shBLOCK/WorldCube/software/GlassLess3DGodot/assets/perspective_splicing/apple7262_0.png

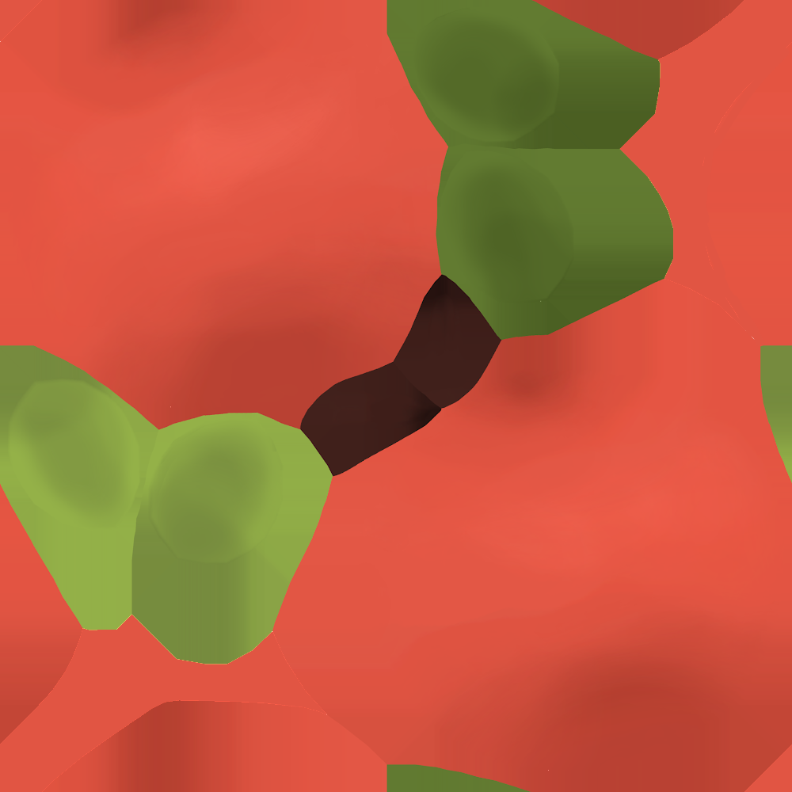
software/GlassLess3DGodot/assets/perspective_splicing/apple7262_0.png
