shBLOCK/WorldCube/software/GlassLess3DGodot/assets/demo/interactive/road2_0.png

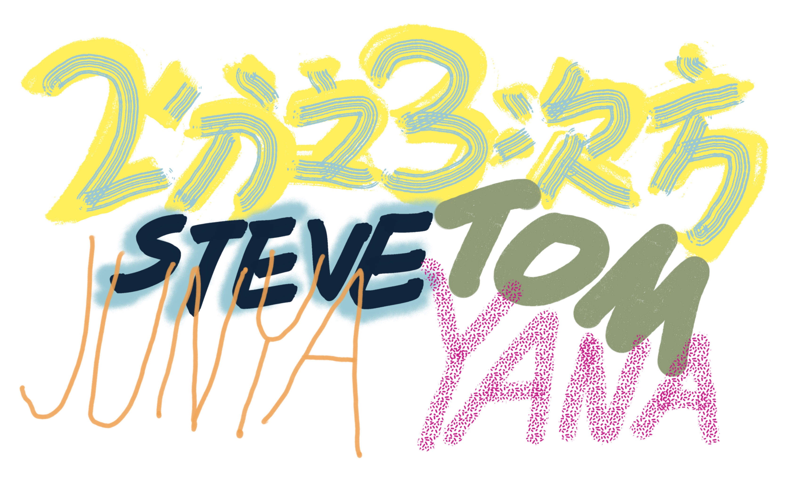
software/GlassLess3DGodot/assets/demo/interactive/road2_0.png
