shBLOCK/WorldCube/software/GlassLess3DGodot/assets/demo/misc/apple726 leaf_1.png

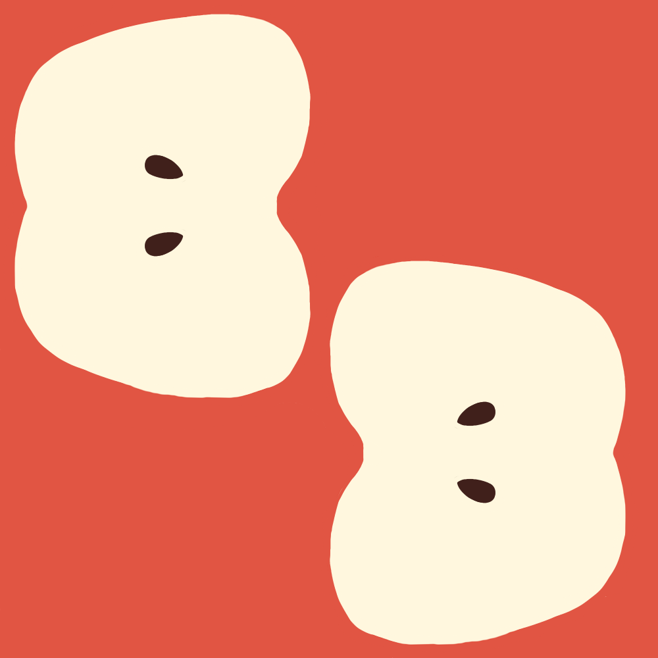
software/GlassLess3DGodot/assets/demo/misc/apple726 leaf_1.png
