shBLOCK/WorldCube/software/GlassLess3DGodot/assets/tmp/susan3.obj

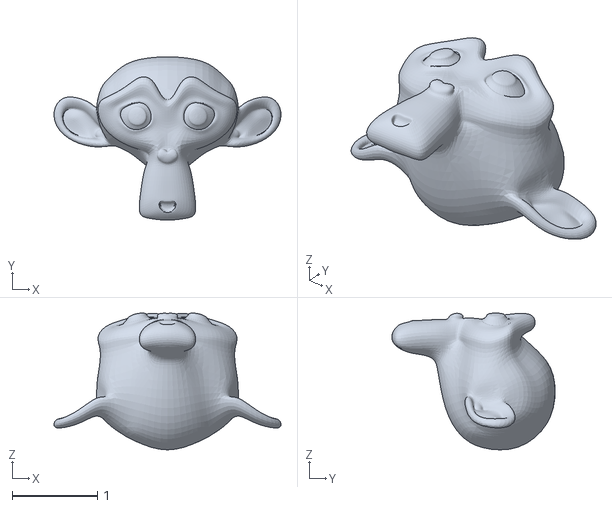
[picture p4: CAD file, 2025-07-24]
software/GlassLess3DGodot/assets/tmp/susan3.obj
2.66 x 1.91 x 1.60
