shBLOCK/WorldCube/pcb/WorldCubeProtoV1/WorldCubeProtoV1.kicad_pcb

## KiCad design pcb/WorldCubeProtoV1/WorldCubeProtoV1.kicad_pcb (2026-03-04)

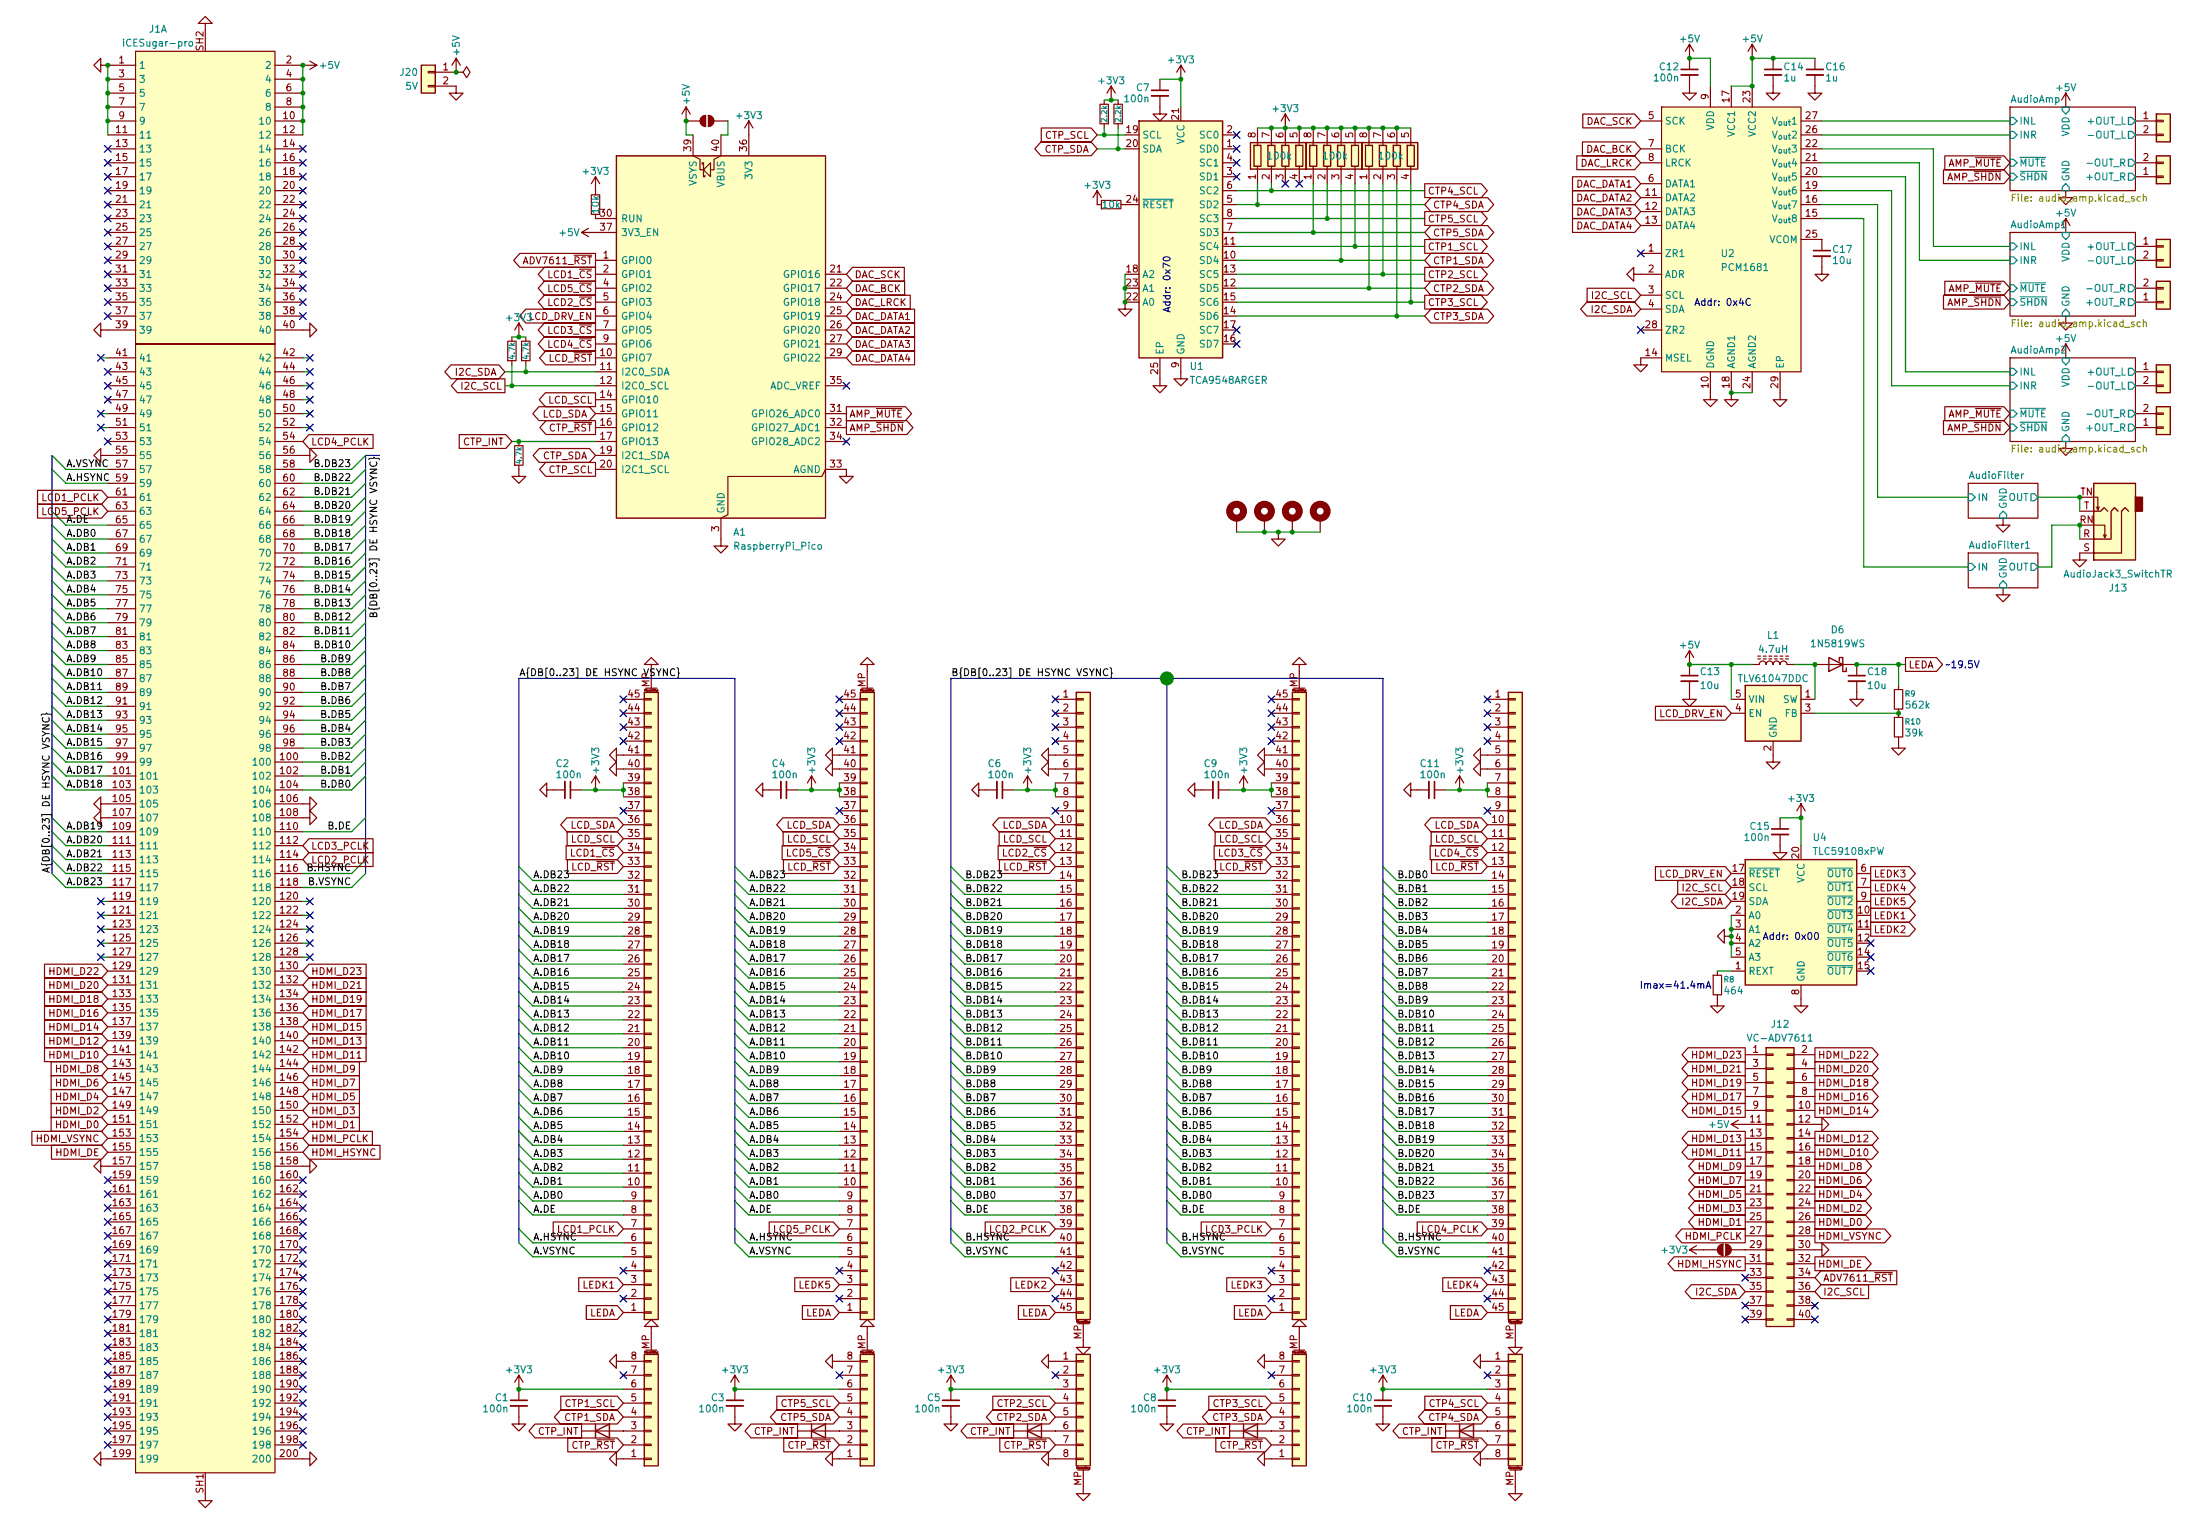
[picture p5: schematic WorldCubeProtoV1.kicad_sch]

Parts:
A1: RaspberryPi_Pico; RaspberryPi_Pico_Common_SMD; LCSC C42924268
C1, C2, C3, C4, C5, C6, C7, C8, C9, C10, C11, C12, C15: 100n; C_0603_1608Metric; LCSC C14663
C13, C18: 10u; C_0805_2012Metric; LCSC C2932476
C14, C16: 1u; C_0603_1608Metric; LCSC C15849
C17: 10u; C_0603_1608Metric; LCSC C19702
D1, D2, D3, D4, D5: 1N4148WT; D_SOD-523; LCSC C7420320
D6: 1N5819WS; D_SOD-323; LCSC C191023
H1, H2, H3, H4: MountingHole_Pad; MountingHole_3.2mm_M3_Pad
J1: iCESugar-pro; TE_1565917-4; LCSC C279171
J2, J4, J8: KD040WXFPD014; TE_4-1734839-5_1x45-1MP_P0.5mm_Horizontal; LCSC C53058
J3, J5, J9: KD040WXFPD014-C015C_CTP; TE_0-1734839-8_1x08-1MP_P0.5mm_Horizontal; LCSC C262555
J6, J10: KD040WXFPD014; TE_4-1734839-5_1x45-1MP_P0.5mm_Horizontal; LCSC C262649
J7, J11: KD040WXFPD014-C015C_CTP; TE_0-1734839-8_1x08-1MP_P0.5mm_Horizontal; LCSC C262581
J12: VC-ADV7611; PinHeader_2x20_P2.54mm_Vertical; LCSC C5224014
J13: AudioJack3_SwitchTR; Jack_3.5mm_CUI_SJ1-3515N_Horizontal; LCSC C145814
J14, J15, J16, J17, J18, J19: Conn_01x02; Molex_PicoBlade_53047-0210_1x02_P1.25mm_Vertical; LCSC C7430458
J20: 5V; JST_XH_B2B-XH-A_1x02_P2.50mm_Vertical; LCSC C158012
JP1, JP2: SolderJumper_2_Open; SolderJumper-2_P1.3mm_Open_RoundedPad1.0x1.5mm
L1: 4.7uH; L_Changjiang_FTC252010S; LCSC C5832360
R1, R6: 10k; R_0603_1608Metric; LCSC C25804
R2, R3, R4: 4.7k; R_0603_1608Metric; LCSC C23162
R5, R7: 2.2k; R_0603_1608Metric; LCSC C4190
R8: 464; R_0603_1608Metric; LCSC C5159701
R9: 562k; R_0603_1608Metric; LCSC C23205
R10: 39k; R_0603_1608Metric; LCSC C23153
RN1, RN2, RN3: 100k; R_Array_Convex_4x0603; LCSC C192933
U1: TCA9548ARGER; Texas_RGE0024C_VQFN-24-1EP_4x4mm_P0.5mm_EP2.1x2.1mm; LCSC C555456
U2: PCM1681; HTSSOP-28-1EP_4.4x9.7mm_P0.65mm_EP3.4x9.5mm_Mask2.4x6.17mm; LCSC C2667052
U3: TLV61047DDC; SOT-23-5; LCSC C44538408
U4: TLC59108xPW; TSSOP-20_4.4x6.5mm_P0.65mm; LCSC C130031

Connections:
+3V3: A1.36 (3V3), C1.1, C2.1, C3.1, C4.1, C5.1, C6.1, C7.1, C8.1, C9.1, C10.1, C11.1, C15.1, J2.38, J2.39, J3.6, J4.38, J4.39, J5.6, J6.7, J6.8, J7.3, J8.38, J8.39, J9.6, J10.7, J10.8, J11.3, JP2.1 (A), R1.2, R2.2, R3.2, R5.2, R6.1, R7.2, RN1.5 (R4.2), RN1.6 (R3.2), RN1.7 (R2.2), RN1.8 (R1.2), RN2.5 (R4.2), RN2.6 (R3.2), RN2.7 (R2.2), RN2.8 (R1.2), RN3.5 (R4.2), RN3.6 (R3.2), RN3.7 (R2.2), RN3.8 (R1.2), U1.21 (VCC), U4.20 (VCC)
+5V: A1.37 (3V3_EN), A1.39 (VSYS), C12.1, C13.1, C14.1, C16.1, J1.2, J1.4, J1.6, J1.8, J1.10, J1.12, J12.11, J20.1, JP1.1 (A), L1.1, U2.9 (VDD), U2.17 (VCC1), U2.23 (VCC2), U3.5 (VIN); also elsewhere on the board
/A.DB0: J1.67, J2.9, J4.9
/A.DB1: J1.69, J2.10, J4.10
/A.DB2: J1.71, J2.11, J4.11
/A.DB3: J1.73, J2.12, J4.12
/A.DB4: J1.75, J2.13, J4.13
/A.DB5: J1.77, J2.14, J4.14
/A.DB6: J1.79, J2.15, J4.15
/A.DB7: J1.81, J2.16, J4.16
/A.DB8: J1.83, J2.17, J4.17
/A.DB9: J1.85, J2.18, J4.18
/A.DB10: J1.87, J2.19, J4.19
/A.DB11: J1.89, J2.20, J4.20
/A.DB12: J1.91, J2.21, J4.21
/A.DB13: J1.93, J2.22, J4.22
/A.DB14: J1.95, J2.23, J4.23
/A.DB15: J1.97, J2.24, J4.24
/A.DB16: J1.99, J2.25, J4.25
/A.DB17: J1.101, J2.26, J4.26
/A.DB18: J1.103, J2.27, J4.27
/A.DB19: J1.109, J2.28, J4.28
/A.DB20: J1.111, J2.29, J4.29
/A.DB21: J1.113, J2.30, J4.30
/A.DB22: J1.115, J2.31, J4.31
/A.DB23: J1.117, J2.32, J4.32
/A.DE: J1.65, J2.8, J4.8
/A.HSYNC: J1.59, J2.6, J4.6
/A.VSYNC: J1.57, J2.5, J4.5
/AudioAmp1/+OUT_L: J16.1; also elsewhere on the board
/AudioAmp1/+OUT_R: J17.1; also elsewhere on the board
/AudioAmp1/-OUT_L: J16.2; also elsewhere on the board
/AudioAmp1/-OUT_R: J17.2; also elsewhere on the board
/AudioAmp1/INL: U2.22 (V_{out}3); also elsewhere on the board
/AudioAmp1/INR: U2.21 (V_{out}4); also elsewhere on the board
/AudioAmp2/+OUT_L: J18.1; also elsewhere on the board
/AudioAmp2/+OUT_R: J19.1; also elsewhere on the board
/AudioAmp2/-OUT_L: J18.2; also elsewhere on the board
/AudioAmp2/-OUT_R: J19.2; also elsewhere on the board
/AudioAmp2/INL: U2.20 (V_{out}5); also elsewhere on the board
/AudioAmp2/INR: U2.19 (V_{out}6); also elsewhere on the board
/AudioAmp/+OUT_L: J14.1; also elsewhere on the board
/AudioAmp/+OUT_R: J15.1; also elsewhere on the board
/AudioAmp/-OUT_L: J14.2; also elsewhere on the board
/AudioAmp/-OUT_R: J15.2; also elsewhere on the board
/AudioAmp/INL: U2.27 (V_{out}1); also elsewhere on the board
/AudioAmp/INR: U2.26 (V_{out}2); also elsewhere on the board
/AudioFilter1/IN: U2.15 (V_{out}8); also elsewhere on the board
/AudioFilter1/OUT: J13.R, J13.RN; also elsewhere on the board
/AudioFilter/IN: U2.16 (V_{out}7); also elsewhere on the board
/AudioFilter/OUT: J13.T, J13.TN; also elsewhere on the board
/B.DB0: J1.104, J6.37, J8.9, J10.14
/B.DB1: J1.102, J6.36, J8.10, J10.15
/B.DB2: J1.100, J6.35, J8.11, J10.16
/B.DB3: J1.98, J6.34, J8.12, J10.17
/B.DB4: J1.96, J6.33, J8.13, J10.18
/B.DB5: J1.94, J6.32, J8.14, J10.19
/B.DB6: J1.92, J6.31, J8.15, J10.20
/B.DB7: J1.90, J6.30, J8.16, J10.21
/B.DB8: J1.88, J6.29, J8.17, J10.22
/B.DB9: J1.86, J6.28, J8.18, J10.23
/B.DB10: J1.84, J6.27, J8.19, J10.24
/B.DB11: J1.82, J6.26, J8.20, J10.25
/B.DB12: J1.80, J6.25, J8.21, J10.26
/B.DB13: J1.78, J6.24, J8.22, J10.27
/B.DB14: J1.76, J6.23, J8.23, J10.28
/B.DB15: J1.74, J6.22, J8.24, J10.29
/B.DB16: J1.72, J6.21, J8.25, J10.30
/B.DB17: J1.70, J6.20, J8.26, J10.31
/B.DB18: J1.68, J6.19, J8.27, J10.32
/B.DB19: J1.66, J6.18, J8.28, J10.33
/B.DB20: J1.64, J6.17, J8.29, J10.34
/B.DB21: J1.62, J6.16, J8.30, J10.35
/B.DB22: J1.60, J6.15, J8.31, J10.36
/B.DB23: J1.58, J6.14, J8.32, J10.37
/B.DE: J1.110, J6.38, J8.8, J10.38
/B.HSYNC: J1.116, J6.40, J8.6, J10.40
/B.VSYNC: J1.118, J6.41, J8.5, J10.41
ADV7611_~RST: A1.1 (GPIO0), J12.34
AMP_~MUTE: A1.31 (GPIO26_ADC0); also elsewhere on the board
AMP_~SHDN: A1.32 (GPIO27_ADC1); also elsewhere on the board
CTP1_SCL: J3.5, RN2.4 (R4.1), U1.11 (SC4)
CTP1_SDA: J3.4, RN2.3 (R3.1), U1.10 (SD4)
CTP2_SCL: J7.4, RN3.2 (R2.1), U1.13 (SC5)
CTP2_SDA: J7.5, RN3.1 (R1.1), U1.12 (SD5)
CTP3_SCL: J9.5, RN3.4 (R4.1), U1.15 (SC6)
CTP3_SDA: J9.4, RN3.3 (R3.1), U1.14 (SD6)
CTP4_SCL: J11.4, RN1.2 (R2.1), U1.6 (SC2)
CTP4_SDA: J11.5, RN1.1 (R1.1), U1.5 (SD2)
CTP5_SCL: J5.5, RN2.2 (R2.1), U1.8 (SC3)
CTP5_SDA: J5.4, RN2.1 (R1.1), U1.7 (SD3)
CTP_INT: A1.17 (GPIO13), D1.1 (K), D2.1 (K), D3.1 (K), D4.1 (K), D5.1 (K), R4.2
CTP_SCL: A1.20 (I2C1_SCL), R5.1, U1.19 (SCL)
CTP_SDA: A1.19 (I2C1_SDA), R7.1, U1.20 (SDA)
CTP_~RST: A1.16 (GPIO12), J3.2, J5.2, J7.7, J9.2, J11.7
DAC_BCK: A1.22 (GPIO17), U2.7 (BCK)
DAC_DATA1: A1.25 (GPIO19), U2.6 (DATA1)
DAC_DATA2: A1.26 (GPIO20), U2.11 (DATA2)
DAC_DATA3: A1.27 (GPIO21), U2.12 (DATA3)
DAC_DATA4: A1.29 (GPIO22), U2.13 (DATA4)
DAC_LRCK: A1.24 (GPIO18), U2.8 (LRCK)
DAC_SCK: A1.21 (GPIO16), U2.5 (SCK)
GND: A1.3 (GND), A1.8 (GND), A1.13 (GND), A1.18 (GND), A1.23 (GND), A1.28 (GND), A1.33 (AGND), A1.38 (GND), C1.2, C2.2, C3.2, C4.2, C5.2, C6.2, C7.2, C8.2, C9.2, C10.2, C11.2, C12.2, C13.2, C14.2, C15.2, C16.2, C17.2, C18.2, H1.1, H2.1, H3.1, H4.1, J1.1, J1.3, J1.5, J1.7, J1.9, J1.11, J1.39, J1.40, J1.55, J1.56, J1.105, J1.106, J1.107, J1.108, J1.157, J1.158, J1.199, J1.200, J1.SH1, J1.SH2, J2.40, J2.41, J2.MP (MountPin), J3.1, J3.8, J3.MP (MountPin), J4.40, J4.41, J4.MP (MountPin), J5.1, J5.8, J5.MP (MountPin), J6.5, J6.6, J6.MP (MountPin), J7.1, J7.8, J7.MP (MountPin), J8.40, J8.41, J8.MP (MountPin), J9.1, J9.8, J9.MP (MountPin), J10.5, J10.6, J10.MP (MountPin), J11.1, J11.8, J11.MP (MountPin), J12.12, J12.30, J13.S, J20.2, R4.1, R8.2, R10.2, U1.9 (GND), U1.18 (A2), U1.22 (A0), U1.23 (A1), U1.25 (EP), U2.2 (ADR), U2.10 (DGND), U2.14 (MSEL), U2.18 (AGND1), U2.24 (AGND2), U2.29 (EP), U3.2 (GND), U4.2 (A0), U4.3 (A1), U4.4 (A2), U4.5 (A3), U4.8 (GND), U4.13 (GND), U4.16 (GND); also elsewhere on the board
HDMI_D0: J1.151, J12.26
HDMI_D1: J1.152, J12.25
HDMI_D2: J1.149, J12.24
HDMI_D3: J1.150, J12.23
HDMI_D4: J1.147, J12.22
HDMI_D5: J1.148, J12.21
HDMI_D6: J1.145, J12.20
HDMI_D7: J1.146, J12.19
HDMI_D8: J1.143, J12.18
HDMI_D9: J1.144, J12.17
HDMI_D10: J1.141, J12.16
HDMI_D11: J1.142, J12.15
HDMI_D12: J1.139, J12.14
HDMI_D13: J1.140, J12.13
HDMI_D14: J1.137, J12.10
HDMI_D15: J1.138, J12.9
HDMI_D16: J1.135, J12.8
HDMI_D17: J1.136, J12.7
HDMI_D18: J1.133, J12.6
HDMI_D19: J1.134, J12.5
HDMI_D20: J1.131, J12.4
HDMI_D21: J1.132, J12.3
HDMI_D22: J1.129, J12.2
HDMI_D23: J1.130, J12.1
HDMI_DE: J1.155, J12.32
HDMI_HSYNC: J1.156, J12.31
HDMI_PCLK: J1.154, J12.27
HDMI_VSYNC: J1.153, J12.28
I2C_SCL: A1.12 (I2C0_SCL), J12.36, R3.1, U2.3 (SCL), U4.18 (SCL)
I2C_SDA: A1.11 (I2C0_SDA), J12.35, R2.1, U2.4 (SDA), U4.19 (SDA)
LCD1_PCLK: J1.61, J2.7
LCD1_~CS: A1.2 (GPIO1), J2.34
LCD2_PCLK: J1.114, J6.39
LCD2_~CS: A1.5 (GPIO3), J6.12
LCD3_PCLK: J1.112, J8.7
LCD3_~CS: A1.7 (GPIO5), J8.34
LCD4_PCLK: J1.54, J10.39
LCD4_~CS: A1.9 (GPIO6), J10.12
LCD5_PCLK: J1.63, J4.7
LCD5_~CS: A1.4 (GPIO2), J4.34
LCD_DRV_EN: A1.6 (GPIO4), U3.4 (EN), U4.17 (~RESET)
LCD_SCL: A1.14 (GPIO10), J2.35, J4.35, J6.11, J8.35, J10.11
LCD_SDA: A1.15 (GPIO11), J2.36, J4.36, J6.10, J8.36, J10.10
LCD_~RST: A1.10 (GPIO7), J2.33, J4.33, J6.13, J8.33, J10.13
LEDA: C18.1, D6.1 (K), J2.1, J4.1, J6.45, J8.1, J10.45, R9.1
LEDK1: J2.3, U4.10 (~OUT3)
LEDK2: J6.43, U4.11 (~OUT4)
LEDK3: J8.3, U4.6 (~OUT0)
LEDK4: J10.43, U4.7 (~OUT1)
LEDK5: J4.3, U4.9 (~OUT2)
unnamed: A1.30 (RUN), R1.1
unnamed: A1.40 (VBUS), JP1.2 (B)
unnamed: D1.2 (A), J3.3
unnamed: D2.2 (A), J5.3
unnamed: D3.2 (A), J7.6
unnamed: D4.2 (A), J9.3
unnamed: D5.2 (A), J11.6
unnamed: D6.2 (A), L1.2, U3.1 (SW)
unnamed: J12.29, JP2.2 (B)
unnamed: R6.2, U1.24 (~RESET)
unnamed: C17.1, U2.25 (VCOM)
unnamed: R9.2, R10.1, U3.3 (FB)
unnamed: R8.1, U4.1 (REXT)

Notes on the sheet:
Addr: 0x4C
Imax=41.4mA
Addr: 0x70
Addr: 0x00
~19.5V

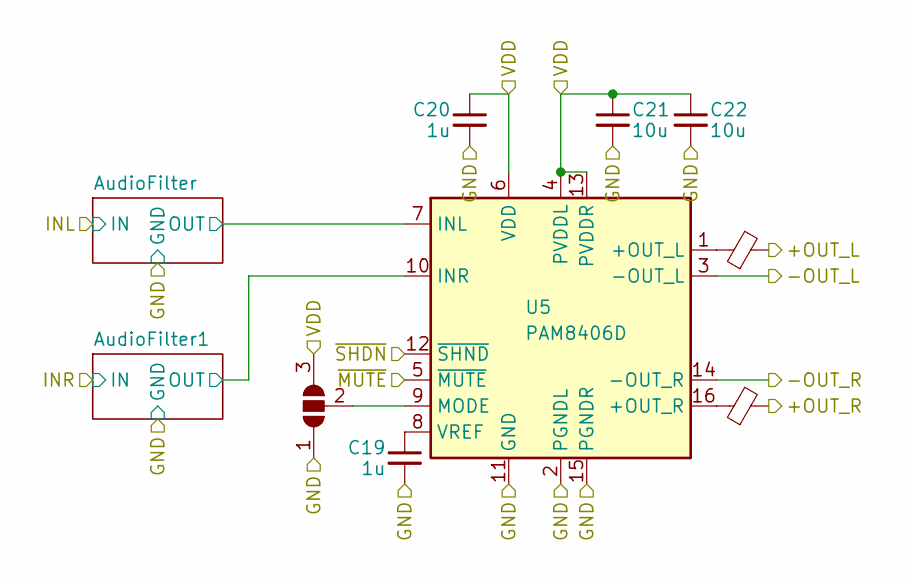
[picture p6: schematic audio_amp.kicad_sch]

Parts:
C19, C20: 1u; C_0603_1608Metric; LCSC C15849
C21, C22: 10u; C_0603_1608Metric; LCSC C19702
FB1, FB2: BLM21PG221SN1D; L_0805_2012Metric; LCSC C85840
JP3: AMP_MODE; SolderJumper-3_P1.3mm_Open_RoundedPad1.0x1.5mm
U5: PAM8406D; SOIC-16_3.9x9.9mm_P1.27mm; LCSC C86270

Connections:
+5V: C20.1, C21.1, C22.1, JP3.3 (B), U5.4 (PVDDL), U5.6 (VDD), U5.13 (PVDDR); also elsewhere on the board
/AudioAmp/+OUT_L: FB1.2; also elsewhere on the board
/AudioAmp/+OUT_R: FB2.2; also elsewhere on the board
/AudioAmp/-OUT_L: U5.3 (-OUT_L); also elsewhere on the board
/AudioAmp/-OUT_R: U5.14 (-OUT_R); also elsewhere on the board
/AudioAmp/AudioFilter1/OUT: U5.10 (INR); also elsewhere on the board
/AudioAmp/AudioFilter/OUT: U5.7 (INL); also elsewhere on the board
AMP_~MUTE: U5.5 (~MUTE); also elsewhere on the board
AMP_~SHDN: U5.12 (~SHND); also elsewhere on the board
GND: C19.2, C20.2, C21.2, C22.2, JP3.1 (A), U5.2 (PGNDL), U5.11 (GND), U5.15 (PGNDR); also elsewhere on the board
unnamed: JP3.2 (C), U5.9 (MODE)
unnamed: FB1.1, U5.1 (+OUT_L)
unnamed: FB2.1, U5.16 (+OUT_R)
unnamed: C19.1, U5.8 (VREF)

Parts of its further copies:
C23, C24, C27, C28: 1u; C_0603_1608Metric; LCSC C15849
C25, C26, C29, C30: 10u; C_0603_1608Metric; LCSC C19702
FB3, FB4, FB5, FB6: BLM21PG221SN1D; L_0805_2012Metric; LCSC C85840
JP4, JP5: AMP_MODE; SolderJumper-3_P1.3mm_Open_RoundedPad1.0x1.5mm
U6, U7: PAM8406D; SOIC-16_3.9x9.9mm_P1.27mm; LCSC C86270

Connections of its further copies:
+5V: C24.1, C25.1, C26.1, C28.1, C29.1, C30.1, JP4.3 (B), JP5.3 (B), U6.4 (PVDDL), U6.6 (VDD), U6.13 (PVDDR), U7.4 (PVDDL), U7.6 (VDD), U7.13 (PVDDR); also elsewhere on the board
/AudioAmp1/+OUT_L: FB3.2; also elsewhere on the board
/AudioAmp1/+OUT_R: FB4.2; also elsewhere on the board
/AudioAmp1/-OUT_L: U6.3 (-OUT_L); also elsewhere on the board
/AudioAmp1/-OUT_R: U6.14 (-OUT_R); also elsewhere on the board
/AudioAmp1/AudioFilter1/OUT: U6.10 (INR); also elsewhere on the board
/AudioAmp1/AudioFilter/OUT: U6.7 (INL); also elsewhere on the board
/AudioAmp2/+OUT_L: FB5.2; also elsewhere on the board
/AudioAmp2/+OUT_R: FB6.2; also elsewhere on the board
/AudioAmp2/-OUT_L: U7.3 (-OUT_L); also elsewhere on the board
/AudioAmp2/-OUT_R: U7.14 (-OUT_R); also elsewhere on the board
/AudioAmp2/AudioFilter1/OUT: U7.10 (INR); also elsewhere on the board
/AudioAmp2/AudioFilter/OUT: U7.7 (INL); also elsewhere on the board
AMP_~MUTE: U6.5 (~MUTE), U7.5 (~MUTE); also elsewhere on the board
AMP_~SHDN: U6.12 (~SHND), U7.12 (~SHND); also elsewhere on the board
GND: C23.2, C24.2, C25.2, C26.2, C27.2, C28.2, C29.2, C30.2, JP4.1 (A), JP5.1 (A), U6.2 (PGNDL), U6.11 (GND), U6.15 (PGNDR), U7.2 (PGNDL), U7.11 (GND), U7.15 (PGNDR); also elsewhere on the board
unnamed: JP4.2 (C), U6.9 (MODE)
unnamed: JP5.2 (C), U7.9 (MODE)
unnamed: FB3.1, U6.1 (+OUT_L)
unnamed: FB4.1, U6.16 (+OUT_R)
unnamed: C23.1, U6.8 (VREF)
unnamed: FB5.1, U7.1 (+OUT_L)
unnamed: FB6.1, U7.16 (+OUT_R)
unnamed: C27.1, U7.8 (VREF)

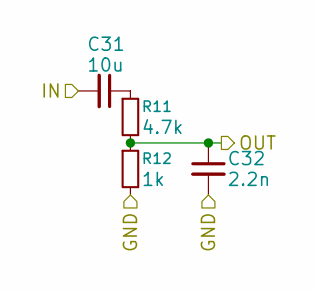
[picture p7: schematic audio_filter.kicad_sch]

Parts:
C31: 10u; C_0603_1608Metric; LCSC C19702
C32: 2.2n; C_0603_1608Metric; LCSC C1604
R11: 4.7k; R_0603_1608Metric; LCSC C23162
R12: 1k; R_0603_1608Metric; LCSC C21190

Connections:
/AudioAmp/AudioFilter/OUT: C32.1, R11.2, R12.1; also elsewhere on the board
/AudioAmp/INL: C31.2; also elsewhere on the board
GND: C32.2, R12.2; also elsewhere on the board
unnamed: C31.1, R11.1

Parts of its further copies:
C33, C35, C37, C39, C41, C43, C45: 10u; C_0603_1608Metric; LCSC C19702
C34, C36, C38, C40, C42, C44, C46: 2.2n; C_0603_1608Metric; LCSC C1604
R13, R15, R17, R19, R21, R23, R25: 4.7k; R_0603_1608Metric; LCSC C23162
R14, R16, R18, R20, R22, R24, R26: 1k; R_0603_1608Metric; LCSC C21190

Connections of its further copies:
/AudioAmp1/AudioFilter1/OUT: C40.1, R19.2, R20.1; also elsewhere on the board
/AudioAmp1/AudioFilter/OUT: C34.1, R13.2, R14.1; also elsewhere on the board
/AudioAmp1/INL: C33.2; also elsewhere on the board
/AudioAmp1/INR: C39.2; also elsewhere on the board
/AudioAmp2/AudioFilter1/OUT: C42.1, R21.2, R22.1; also elsewhere on the board
/AudioAmp2/AudioFilter/OUT: C36.1, R15.2, R16.1; also elsewhere on the board
/AudioAmp2/INL: C35.2; also elsewhere on the board
/AudioAmp2/INR: C41.2; also elsewhere on the board
/AudioAmp/AudioFilter1/OUT: C38.1, R17.2, R18.1; also elsewhere on the board
/AudioAmp/INR: C37.2; also elsewhere on the board
/AudioFilter1/IN: C45.2; also elsewhere on the board
/AudioFilter1/OUT: C46.1, R25.2, R26.1; also elsewhere on the board
/AudioFilter/IN: C43.2; also elsewhere on the board
/AudioFilter/OUT: C44.1, R23.2, R24.1; also elsewhere on the board
GND: C34.2, C36.2, C38.2, C40.2, C42.2, C44.2, C46.2, R14.2, R16.2, R18.2, R20.2, R22.2, R24.2, R26.2; also elsewhere on the board
unnamed: C33.1, R13.1
unnamed: C35.1, R15.1
unnamed: C37.1, R17.1
unnamed: C39.1, R19.1
unnamed: C41.1, R21.1
unnamed: C43.1, R23.1
unnamed: C45.1, R25.1

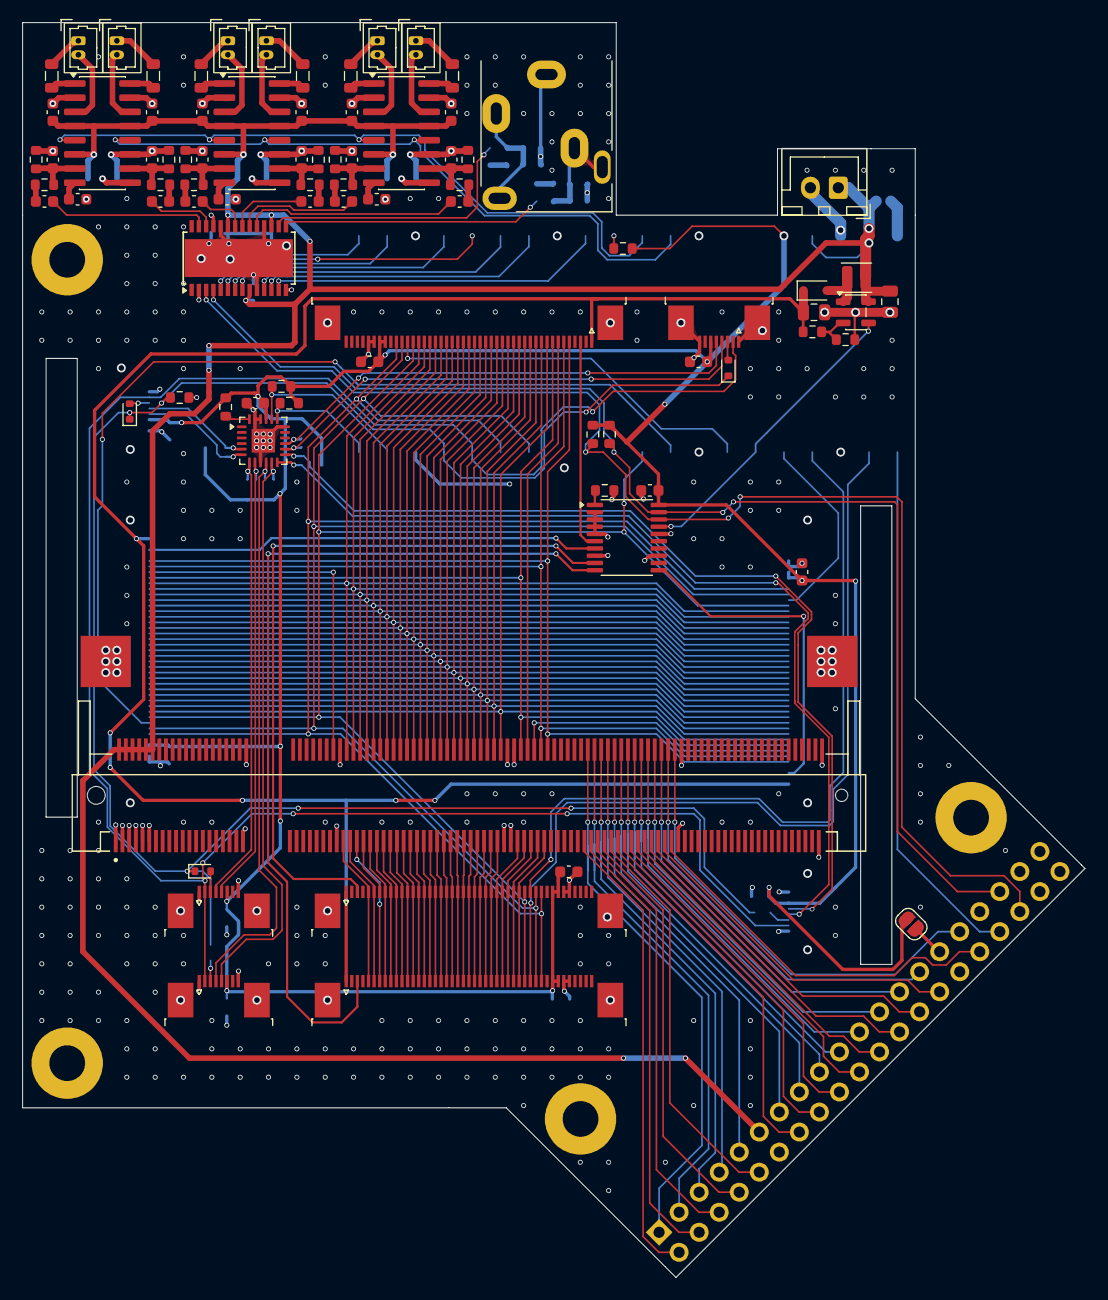
[picture p8: board WorldCubeProtoV1.kicad_pcb from above]

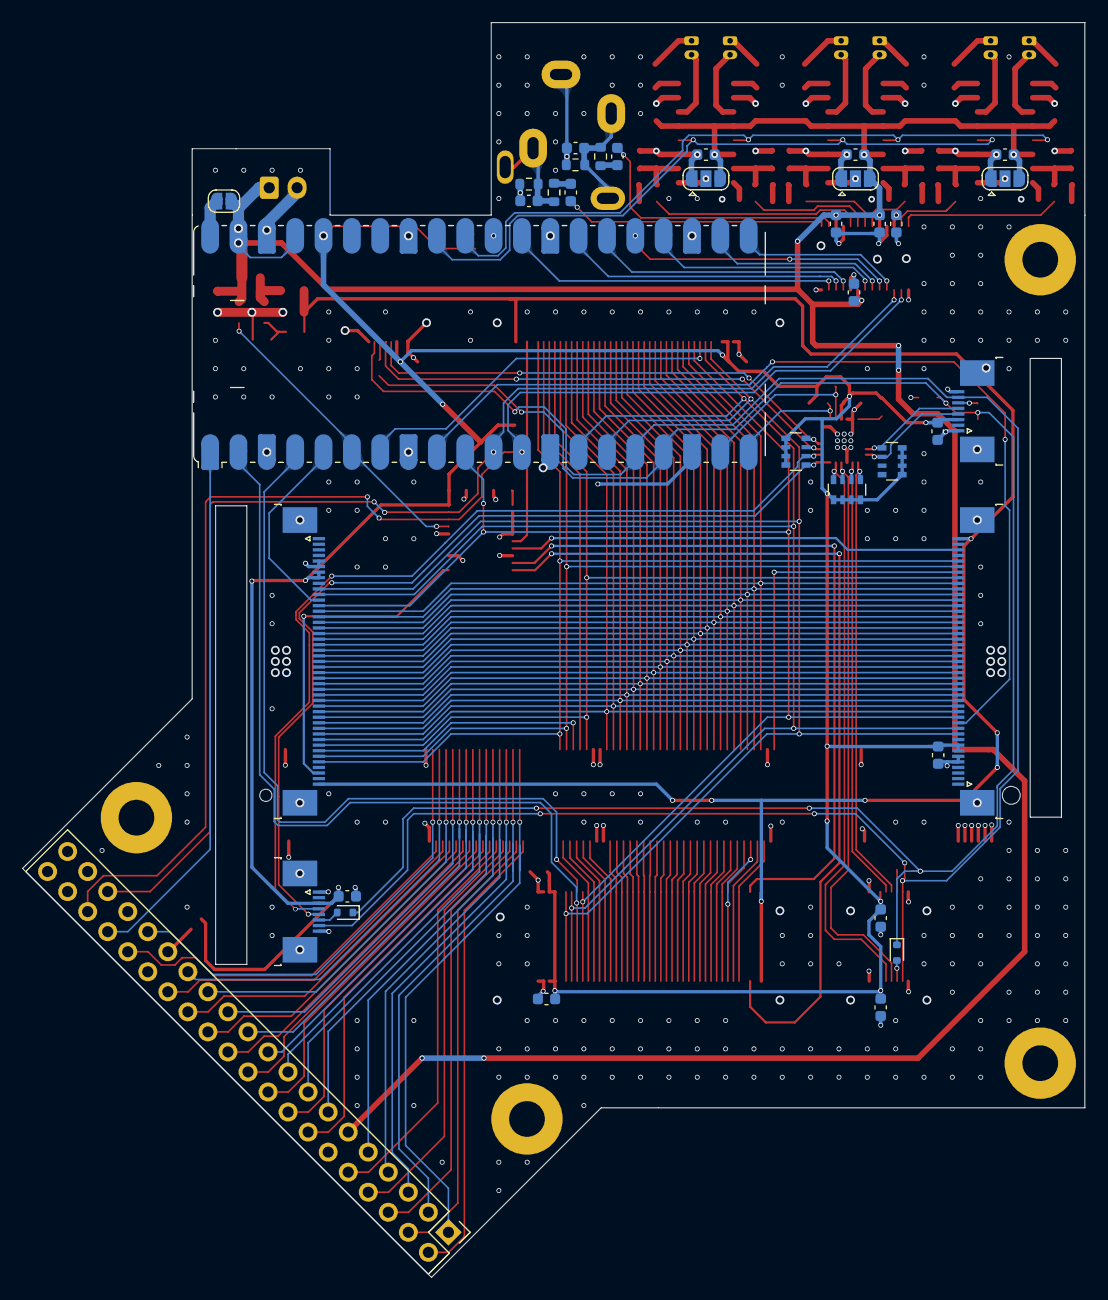
[picture p9: board WorldCubeProtoV1.kicad_pcb from below]

Board: 4 copper layers, 95.2 x 112.5 mm, 125 parts (36 on the bottom side), 192 nets.
