shBLOCK/WorldCube/pcb/WorldCubeProtoV1/audio_amp.kicad_pcb

## KiCad design pcb/WorldCubeProtoV1/audio_amp.kicad_pcb (2026-03-04)

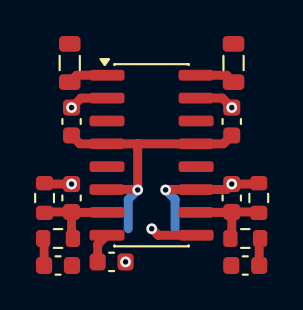
[picture p10: board audio_amp.kicad_pcb from above]

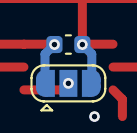
[picture p11: board audio_amp.kicad_pcb from below]

Board: 2 copper layers, 16 parts (2 on the bottom side), 10 nets.

Parts:
C1, C2: 1u; C_0603_1608Metric
C3, C4, C5, C7: 10u; C_0603_1608Metric
C6, C8: 2.2n; C_0603_1608Metric
FB1, FB2: BLM21PG221SN1D; L_0805_2012Metric
JP1: AMP_MODE; SolderJumper-3_P1.3mm_Open_RoundedPad1.0x1.5mm
R1, R3: 4.7k; R_0603_1608Metric
R2, R4: 1k; R_0603_1608Metric
U1: PAM8406D; SOIC-16_3.9x9.9mm_P1.27mm

Connections:
/AudioFilter1/OUT: C8.1, R3.2, R4.1, U1.10 (INR)
/AudioFilter/OUT: C6.1, R1.2, R2.1, U1.7 (INL)
/GND: C1.2, C2.2, C3.2, C4.2, C6.2, C8.2, JP1.1 (A), R2.2, R4.2, U1.2 (PGNDL), U1.11 (GND), U1.15 (PGNDR)
/VDD: C2.1, C3.1, C4.1, JP1.3 (B), U1.4 (PVDDL), U1.6 (VDD), U1.13 (PVDDR)
unnamed: C5.1, R1.1
unnamed: C7.1, R3.1
unnamed: JP1.2 (C), U1.9 (MODE)
unnamed: FB1.1, U1.1 (+OUT_L)
unnamed: FB2.1, U1.16 (+OUT_R)
unnamed: C1.1, U1.8 (VREF)
