shBLOCK/WorldCube/tools/tmp/Validation_Cube_PCB/Validation_Cube_PCB.kicad_pcb

## KiCad design tools/tmp/Validation_Cube_PCB/Validation_Cube_PCB.kicad_pcb (2025-07-26)

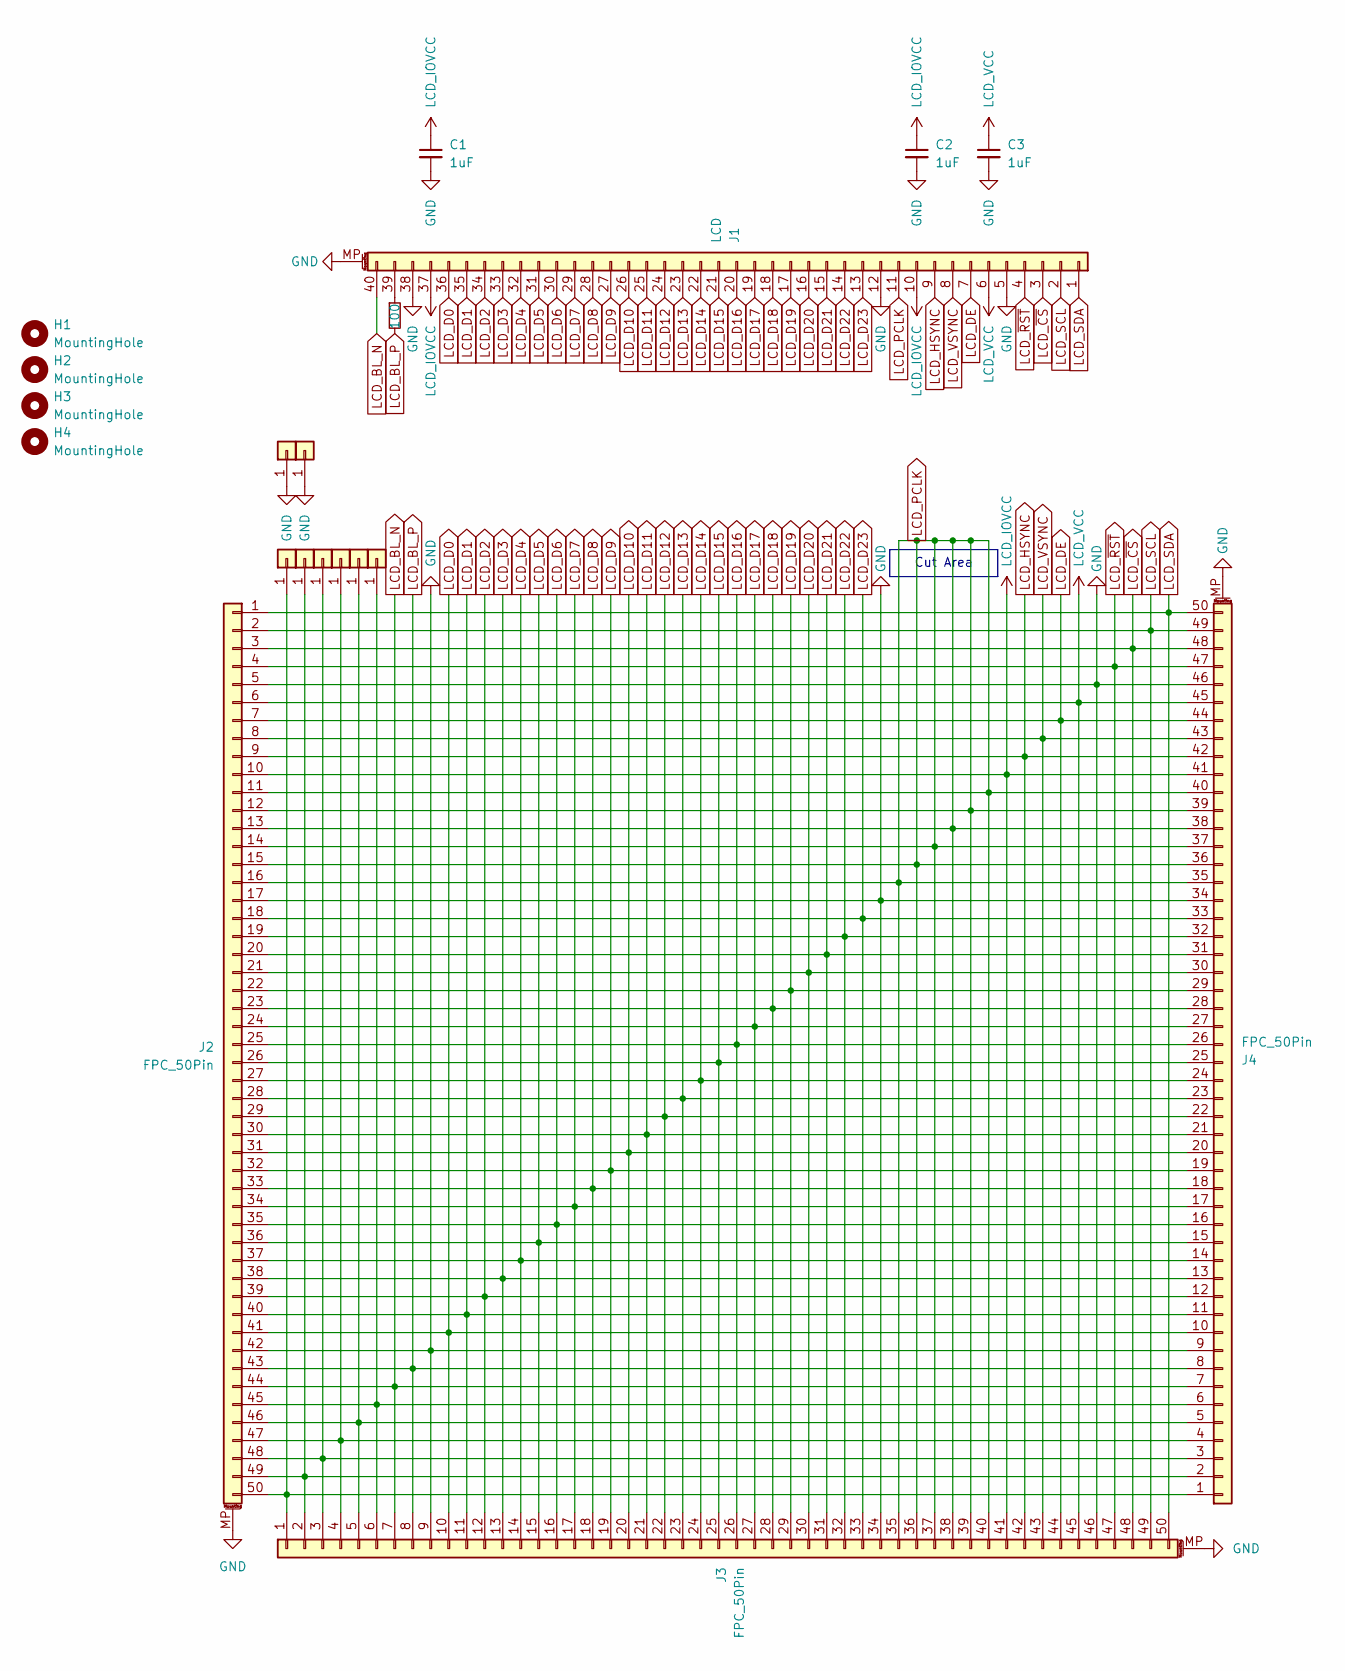
[picture p12: schematic Validation_Cube_PCB.kicad_sch]

Parts:
C1, C2, C3: 1uF; C_0603_1608Metric; LCSC C15849
H1, H2, H3, H4: MountingHole; MountingHole_3.2mm_M3
J1: LCD; TE_4-1734839-0_1x40-1MP_P0.5mm_Horizontal; LCSC C262648
J2, J3, J4: FPC_50Pin; TE_5-1734839-0_1x50-1MP_P0.5mm_Horizontal; LCSC C262650
J5, J6, J7, J8, J9, J10, J11, J12: Conn_01x01; SolderWire-0.1sqmm_1x01_D0.4mm_OD1mm
R1: 100; R_1206_3216Metric; LCSC C17901

Connections:
GND: C1.2, C2.2, C3.2, J1.5, J1.12, J1.38, J1.MP (MountPin), J2.5, J2.17, J2.42, J2.MP (MountPin), J3.9, J3.34, J3.46, J3.MP (MountPin), J4.9, J4.34, J4.46, J4.MP (MountPin), J11.1, J12.1
LCD_BL_N: J1.40, J2.44, J3.7, J4.7
LCD_BL_P: J2.43, J3.8, J4.8, R1.2
LCD_D0: J1.36, J2.41, J3.10, J4.10
LCD_D1: J1.35, J2.40, J3.11, J4.11
LCD_D2: J1.34, J2.39, J3.12, J4.12
LCD_D3: J1.33, J2.38, J3.13, J4.13
LCD_D4: J1.32, J2.37, J3.14, J4.14
LCD_D5: J1.31, J2.36, J3.15, J4.15
LCD_D6: J1.30, J2.35, J3.16, J4.16
LCD_D7: J1.29, J2.34, J3.17, J4.17
LCD_D8: J1.28, J2.33, J3.18, J4.18
LCD_D9: J1.27, J2.32, J3.19, J4.19
LCD_D10: J1.26, J2.31, J3.20, J4.20
LCD_D11: J1.25, J2.30, J3.21, J4.21
LCD_D12: J1.24, J2.29, J3.22, J4.22
LCD_D13: J1.23, J2.28, J3.23, J4.23
LCD_D14: J1.22, J2.27, J3.24, J4.24
LCD_D15: J1.21, J2.26, J3.25, J4.25
LCD_D16: J1.20, J2.25, J3.26, J4.26
LCD_D17: J1.19, J2.24, J3.27, J4.27
LCD_D18: J1.18, J2.23, J3.28, J4.28
LCD_D19: J1.17, J2.22, J3.29, J4.29
LCD_D20: J1.16, J2.21, J3.30, J4.30
LCD_D21: J1.15, J2.20, J3.31, J4.31
LCD_D22: J1.14, J2.19, J3.32, J4.32
LCD_D23: J1.13, J2.18, J3.33, J4.33
LCD_DE: J1.7, J2.7, J3.44, J4.44
LCD_HSYNC: J1.9, J2.9, J3.42, J4.42
LCD_IOVCC: C1.1, C2.1, J1.10, J1.37, J2.10, J3.41, J4.41
LCD_PCLK: J1.11, J2.11, J2.12, J2.13, J2.14, J2.15, J2.16, J3.35, J3.36, J3.37, J3.38, J3.39, J3.40, J4.35, J4.36, J4.37, J4.38, J4.39, J4.40
LCD_SCL: J1.2, J2.2, J3.49, J4.49
LCD_SDA: J1.1, J2.1, J3.50, J4.50
LCD_VCC: C3.1, J1.6, J2.6, J3.45, J4.45
LCD_VSYNC: J1.8, J2.8, J3.43, J4.43
LCD_~CS: J1.3, J2.3, J3.48, J4.48
LCD_~RST: J1.4, J2.4, J3.47, J4.47
unnamed: J1.39, R1.1
unnamed: J2.46, J3.5, J4.5, J9.1
unnamed: J2.47, J3.4, J4.4, J8.1
unnamed: J2.48, J3.3, J4.3, J7.1
unnamed: J2.49, J3.2, J4.2, J6.1
unnamed: J2.50, J3.1, J4.1, J5.1
unnamed: J2.45, J3.6, J4.6, J10.1

Notes on the sheet:
Cut Area

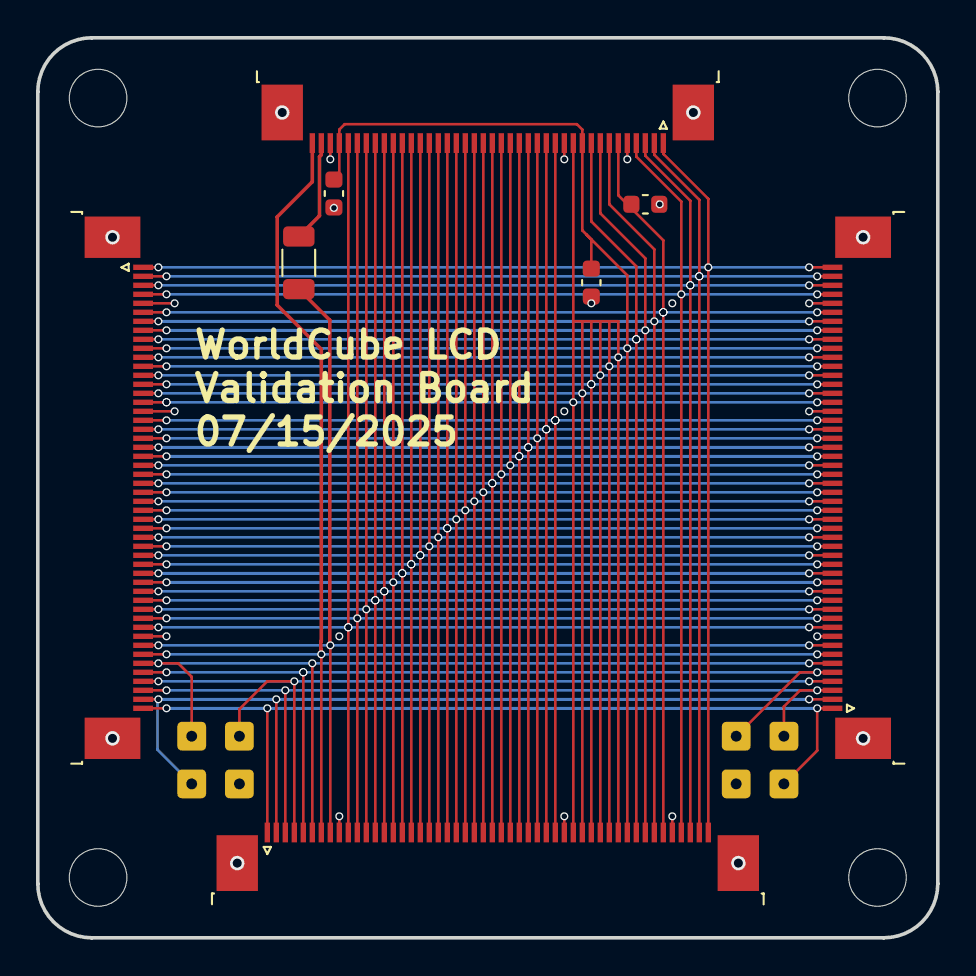
[picture p13: board Validation_Cube_PCB.kicad_pcb from above]

Board: 4 copper layers, 50.0 x 50.0 mm, 20 parts (0 on the bottom side), 44 nets.
