shBLOCK/WorldCube/tools/tmp/Validation_Driver_PCB/Validation_Driver_PCB.kicad_pcb

## KiCad design tools/tmp/Validation_Driver_PCB/Validation_Driver_PCB.kicad_pcb (2025-07-26)

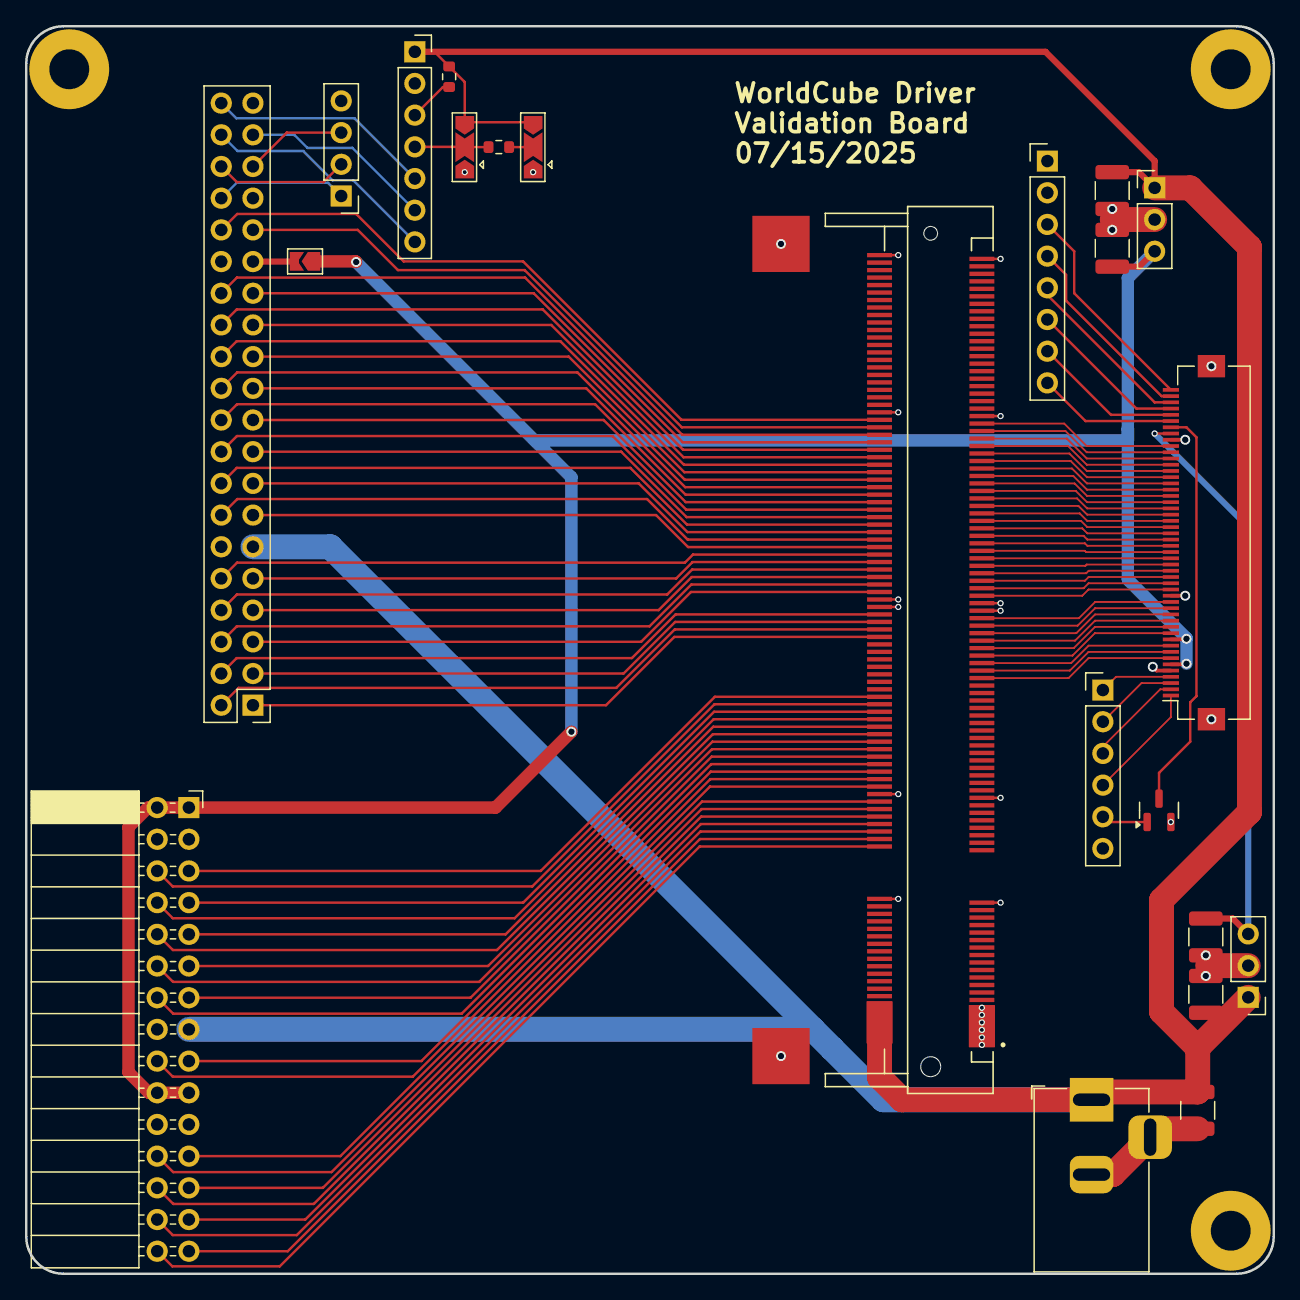
[picture p14: board Validation_Driver_PCB.kicad_pcb from above]

Board: 4 copper layers, 100.0 x 100.0 mm, 25 parts (0 on the bottom side), 107 nets.

Parts:
C1, C2, C3, C4, C5: 47uF 25V; C_1210_3225Metric
H1, H2, H3: MountingHole_Pad; MountingHole_3.2mm_M3_Pad
J1: ICESugar-Pro; TE_1565917-4
J2: VC-ADV7611; PinHeader_2x20_P2.54mm_Vertical
J4: MAX98357_Module; PinSocket_1x07_P2.54mm_Vertical
J7: FPC_50Pin; Hirose_FH12-50S-0.5SH_1x50-1MP_P0.50mm_Horizontal
J8: Misc; PinHeader_1x08_P2.54mm_Vertical
J9: LCD_Ctrl; PinHeader_1x06_P2.54mm_Vertical
J10: ADV7611_Init; PinHeader_1x04_P2.54mm_Vertical
J11: LCD_BL_DCDC; PinHeader_1x03_P2.54mm_Vertical
J12: 3V3_DCDC; PinHeader_1x03_P2.54mm_Vertical
J14: FPGA_GPIO; PinSocket_2x15_P2.54mm_Horizontal
J15: 5V_IN; BarrelJack_Horizontal
JP3: SolderJumper_2_Open; SolderJumper-2_P1.3mm_Open_TrianglePad1.0x1.5mm
JP4, JP5: SolderJumper_3_Open; SolderJumper-3_P2.0mm_Open_TrianglePad1.0x1.5mm
Q1: AO3400A; SOT-23
R1: 100k; R_0603_1608Metric
R2: 1M; R_0603_1608Metric

Connections:
+3V3: C4.1, J7.6, J7.10, J12.3, J14.1, J14.2, J14.19, J14.20, JP3.1 (A)
+5V: C1.1, C3.1, C5.1, J1.2, J1.4, J1.6, J1.8, J1.10, J1.12, J2.11, J4.1, J11.1, J12.1, J14.15, J15.1, JP4.3 (B), JP5.3 (B), R2.1
ADV7611_SCL: J2.36, J10.2
ADV7611_SDA: J2.35, J10.3
ADV7611_~RST: J2.34, J10.1
FPGA_GPIO_0: J1.82, J14.5
FPGA_GPIO_1: J1.80, J14.6
FPGA_GPIO_2: J1.78, J14.7
FPGA_GPIO_3: J1.76, J14.8
FPGA_GPIO_4: J1.74, J14.9
FPGA_GPIO_5: J1.72, J14.10
FPGA_GPIO_6: J1.70, J14.11
FPGA_GPIO_7: J1.68, J14.12
FPGA_GPIO_8: J1.66, J14.13
FPGA_GPIO_9: J1.64, J14.14
FPGA_GPIO_10: J1.62, J14.17
FPGA_GPIO_11: J1.60, J14.18
FPGA_GPIO_12: J1.58, J14.23
FPGA_GPIO_13: J1.54, J14.24
FPGA_GPIO_14: J1.52, J14.25
FPGA_GPIO_15: J1.50, J14.26
FPGA_GPIO_16: J1.48, J14.27
FPGA_GPIO_17: J1.46, J14.28
FPGA_GPIO_18: J1.44, J14.29
FPGA_GPIO_19: J1.42, J14.30
GND: C1.2, C2.2, C3.2, C4.2, C5.2, H1.1, H2.1, H3.1, J1.1, J1.3, J1.5, J1.7, J1.9, J1.11, J1.39, J1.40, J1.55, J1.56, J1.105, J1.106, J1.107, J1.108, J1.157, J1.158, J1.199, J1.200, J1.SH1 (SHIELD), J1.SH2 (SHIELD), J2.12, J2.30, J4.2, J7.5, J7.17, J7.42, J7.MP (MountPin), J8.1, J8.2, J9.6, J10.4, J11.2, J12.2, J14.3, J14.4, J14.16, J14.21, J14.22, J15.2, J15.3, JP4.1 (A), JP5.1 (A), Q1.2 (S)
I2S_DIN: J2.40, J4.5
I2S_LRCLK: J2.38, J4.7
I2S_SCLK: J2.37, J4.6
LCD_BL_CTL: J9.5, Q1.1 (G)
LCD_BL_P: C2.1, J7.43, J11.3
LCD_D0: J1.155, J7.41
LCD_D1: J1.153, J7.40
LCD_D2: J1.151, J7.39
LCD_D3: J1.149, J7.38
LCD_D4: J1.147, J7.37
LCD_D5: J1.145, J7.36
LCD_D6: J1.143, J7.35
LCD_D7: J1.141, J7.34
LCD_D8: J1.139, J7.33
LCD_D9: J1.137, J7.32
LCD_D10: J1.135, J7.31
LCD_D11: J1.133, J7.30
LCD_D12: J1.131, J7.29
LCD_D13: J1.129, J7.28
LCD_D14: J1.127, J7.27
LCD_D15: J1.125, J7.26
LCD_D16: J1.123, J7.25
LCD_D17: J1.121, J7.24
LCD_D18: J1.119, J7.23
LCD_D19: J1.117, J7.22
LCD_D20: J1.115, J7.21
LCD_D21: J1.113, J7.20
LCD_D22: J1.111, J7.19
LCD_D23: J1.109, J7.18
LCD_DE: J1.87, J7.7
LCD_HSYNC: J1.91, J7.9
LCD_PCLK_0: J1.103, J7.16
LCD_PCLK_1: J1.101, J7.15
LCD_PCLK_2: J1.99, J7.14
LCD_PCLK_3: J1.97, J7.13
LCD_PCLK_4: J1.95, J7.12
LCD_PCLK_5: J1.93, J7.11
LCD_SCL: J7.2, J9.3
LCD_SDA: J7.1, J9.4
LCD_VSYNC: J1.89, J7.8
LCD_~CS: J7.3, J9.2
LCD_~RST: J7.4, J9.1
unnamed: J2.29, JP3.2 (B)
unnamed: J4.3, R2.2
unnamed: J4.4, JP4.2 (C), R1.2
unnamed: J7.44, Q1.3 (D)
unnamed: J7.45, J8.8
unnamed: J7.46, J8.7
unnamed: J7.47, J8.6
unnamed: J7.48, J8.5
unnamed: J7.49, J8.4
unnamed: J7.50, J8.3
unnamed: JP5.2 (C), R1.1
VIDIN_D0: J1.148, J2.26
VIDIN_D1: J1.146, J2.25
VIDIN_D2: J1.144, J2.24
VIDIN_D3: J1.142, J2.23
VIDIN_D4: J1.140, J2.22
VIDIN_D5: J1.138, J2.21
VIDIN_D6: J1.136, J2.20
VIDIN_D7: J1.134, J2.19
VIDIN_D8: J1.132, J2.18
VIDIN_D9: J1.130, J2.17
VIDIN_D10: J1.128, J2.16
VIDIN_D11: J1.126, J2.15
VIDIN_D12: J1.124, J2.14
VIDIN_D13: J1.122, J2.13
VIDIN_D14: J1.120, J2.10
VIDIN_D15: J1.118, J2.9
VIDIN_D16: J1.116, J2.8
VIDIN_D17: J1.114, J2.7
VIDIN_D18: J1.112, J2.6
VIDIN_D19: J1.110, J2.5
VIDIN_D20: J1.104, J2.4
VIDIN_D21: J1.102, J2.3
VIDIN_D22: J1.100, J2.2
VIDIN_D23: J1.98, J2.1
VIDIN_DE: J1.156, J2.32
VIDIN_HS: J1.154, J2.31
VIDIN_PCLK: J1.150, J2.27
VIDIN_VS: J1.152, J2.28
