shBLOCK/WorldCube/(commit log)

2025-07-10 FPGA parallel bus LCD driver work
2025-07-24 FlipGo demo working in Godot!
    [plugin.cfg, susan3.obj]
2026-03-03 New prototype PCB progress
    [WorldCubeProtoV1.kicad_pcb, WorldCubeProtoV1.kicad_sch, audio_amp.kicad_sch, audio_filter.kicad_sch, lcd.kicad_sch]
